MMNT-ai/auto-mode-fan-controller/simulation/Schematic.png

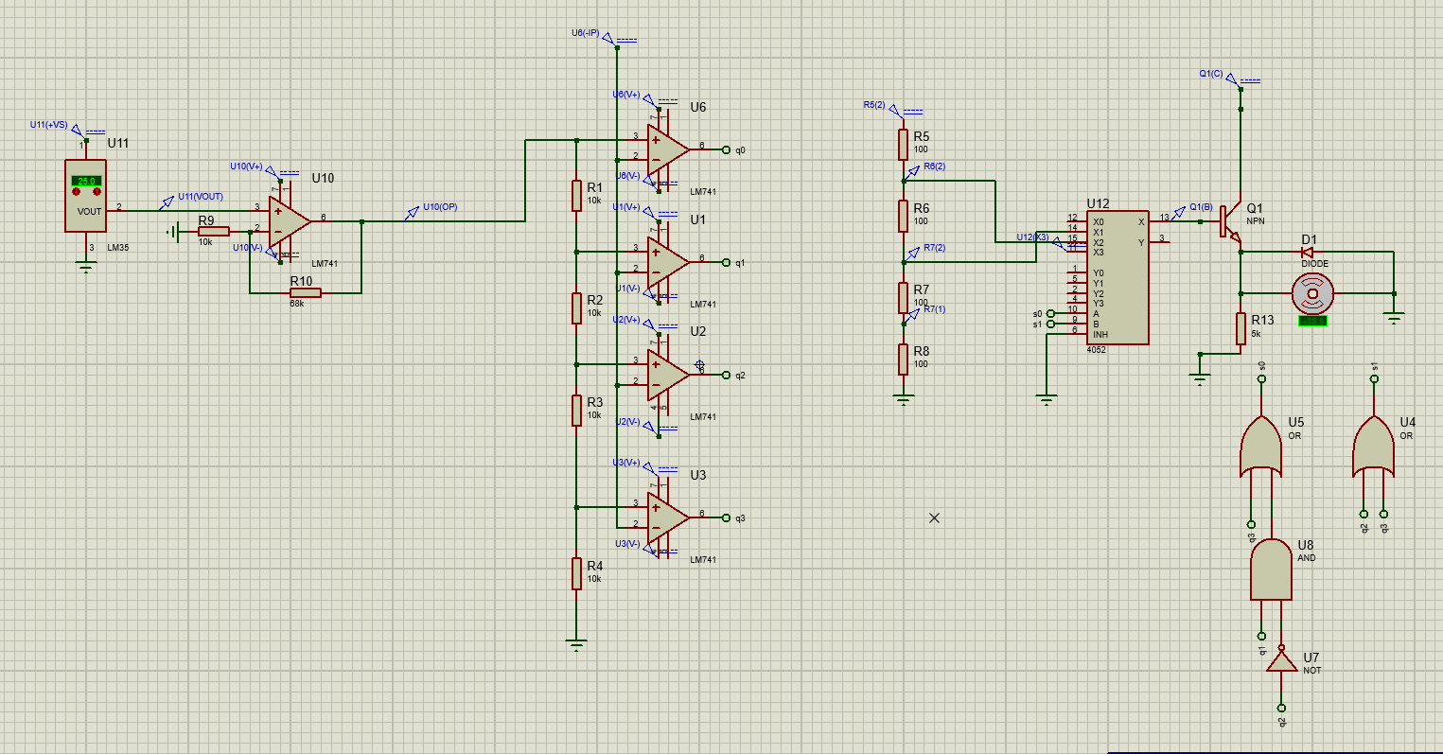
simulation/Schematic.png
