MMNT-ai/auto-mode-fan-controller/(list of files, drawings)

Other design files:
simulation/Task1_Mohamed_Mostafa.pdsprj
