MMNT-ai/auto-mode-fan-controller/(commit log)

2026-09-18 Revise README for Auto-Mode Fan Controller project
    Updated the README to provide a comprehensive overview of the Automatic Multi-Speed Fan Controller project, including its features, engineering highlights, circuit architecture, and bill of materials.
2026-09-18 Update README with PCB image and description
    Added an image and description for the assembled PCB.
